Sundsturm/Oscillator-Circuit_13222083/PROYEK-2_SIM.asc

C1: cap; 0.068µ; V=100 Irms=0 Rser=0 Lser=0
C2: cap; 0.022µ; V=100 Irms=0 Rser=0 Lser=0
C_C: polcap; 1000µ; V=50 Irms=890m Rser=0.068 Lser=25n
L: ind; 12µ
Q1: npn; 2N2222
R_1: res; 120k
R_2: res; 56k
R_E: res; 2k7
V1: voltage; 15
Named nets: VCC, 0, Vout
.tran 0 10m 0 1u
.measure TRAN VPP PP V(Vout)
